pelrun/blutwid/hardware/blutwid.xlsx

 |  |  |  |  |  |  | Board Qty: | 100
 |  |  |  |  |  |  | Total Cost: | $0.00 |  |  |  | $0.00 |  |  |  |  |  | $0.00 |  |  |  |  |  | $0.00
Global Part Info |  |  |  |  |  |  |  |  | Newark |  |  |  |  |  | Digi-Key |  |  |  |  |  | Mouser
Refs | Value | Desc | Footprint | Manf | Manf# | Qty | Unit$ | Ext$ | Avail | Purch | Unit$ | Ext$ | Cat# | Doc | Avail | Purch | Unit$ | Ext$ | Cat# | Doc | Avail | Purch | Unit$ | Ext$ | Cat# | Doc
C9,C10 | 0.1u |  | w_smd_cap:c_0402 |  |  | 0 | $0.00 | $0.00
J1 | KBD/MS |  | w_pin_strip:pin_strip_6 |  |  | 0 | $0.00 | $0.00
C1-C4 | 10uF |  | w_smd_cap:c_1206 |  |  | 0 | $0.00 | $0.00
J2 | SWD |  | w_pin_strip:pin_strip_5 |  |  | 0 | $0.00 | $0.00
J5-J8 | M |  | w_pin_strip:pin_strip_1 |  |  | 0 | $0.00 | $0.00
P2 | BATT |  | w_pin_strip:pin_strip_2 |  |  | 0 | $0.00 | $0.00
C5 | 1uF |  | w_smd_cap:c_0805 |  |  | 0 | $0.00 | $0.00
J3 | BRD1 |  | w_pin_strip:pin_strip_6 |  |  | 0 | $0.00 | $0.00
U5 | STM32F030 |  | w_smd_lqfp:lqfp32 |  | STM32F030K6T6 | 0 | $0.00 | $0.00 | 2 |  | $0.00 | $0.00 | 75X0275 | Link (http://www.newark.com/webapp/wcs/stores/servlet/Search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) | 5690 |  | $0.00 | $0.00 | 497-14046-ND | Link (http://www.digikey.com/scripts/DkSearch/dksus.dll?WT.z_header=search_go&lang=en) | 3442 |  | $0.00 | $0.00 | 511-STM32F030K6T6 | Link (http://www.mouser.com/Search/Refine.aspx?Keyword=STM32F030K6T6)
SW1 | WKUP |  | Buttons_Switches_SMD:SW_SPST_EVQP7A |  | EVQP7A01K | 0 | $0.00 | $0.00 | 3065 |  | $0.00 | $0.00 | 83T2830 | Link (http://www.newark.com/panasonic-electronic-components/evq-p7a01p/switch-tactile-spst-no-50ma-12vdc/dp/83T2830) | 0 |  | $0.00 | $0.00 | P12277STR-ND | Link (http://www.digikey.com/scripts/DkSearch/dksus.dll?WT.z_header=search_go&lang=en&keywords=EVQP7A01K) |  |  | $0.00 | $0.00 | 667-EVQ-P7A01K | Link (http://www.mouser.com/Search/Refine.aspx?Keyword=EVQP7A01K)
U2 | Roving_RN-42 |  | w_rf_modules:w_rf_modules%3aroving_rn-42 |  | RN42-I/RM | 0 | $0.00 | $0.00 | 0 |  | $0.00 | $0.00 | 06W3305 | Link (http://www.newark.com/webapp/wcs/stores/servlet/Search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) | 4053 |  | $0.00 | $0.00 | 740-1038-2-ND | Link (http://www.digikey.com/product-detail/en/RN42-I%2FRM/740-1038-2-ND/2742152) | 1662 |  | $0.00 | $0.00 | 765-RN-42 | Link (http://www.mouser.com/Search/../ProductDetail/Microchip-Technology/RN42-I-RM/)
U3 | MCP73831T-2 |  | w_smd_trans:sot23-5 |  | MCP73831T-2ATI/OT | 0 | $0.00 | $0.00 | 997 |  | $0.00 | $0.00 | 84R5196 | Link (http://www.newark.com/microchip/mcp73831t-2ati-ot/battery-charger-500-ma-5-sot-23/dp/84R5196) | 4887 |  | $0.00 | $0.00 | MCP73831T-2ATI/OTCT-ND | Link (http://www.digikey.com/product-detail/en/MCP73831T-2ATI%2FOT/MCP73831T-2ATI%2FOTCT-ND/1979803) | 8496 |  | $0.00 | $0.00 | 579-MCP73831T-2ATIOT | Link (http://www.mouser.com/Search/Refine.aspx?Keyword=MCP73831T-2ATI%2FOT)
P1 | USB-5PIN |  | w_conn_pc:conn_usb_B_micro_smd-2 |  | USB3065-30-00-A | 0 | $0.00 | $0.00 | 1799 |  | $0.00 | $0.00 | 58T0860 | Link (http://www.newark.com/global-connector-technology/usb3065-30-00-a/micro-usb-2-0-type-b-recetpacle/dp/58T0860)
U4 | REG_3V3 |  | w_smd_trans:sot23-5 |  |  | 0 | $0.00 | $0.00
J9 | PWR |  | w_pin_strip:pin_strip_2 |  |  | 0 | $0.00 | $0.00
Q1 | MOS_N_DGS |  | w_smd_trans:sot23 |  |  | 0 | $0.00 | $0.00
J4 | BRD2 |  | w_pin_strip:pin_strip_6 |  |  | 0 | $0.00 | $0.00
U1 | MCP1253-33X50 |  | w_smd_dil:msoic-8 |  | MCP1253-33X50I/MS | 0 | $0.00 | $0.00 | 399 |  | $0.00 | $0.00 | 03H5060 | Link (http://www.newark.com/webapp/wcs/stores/servlet/Search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) | 1013 |  | $0.00 | $0.00 | MCP1253-33X50I/MS-ND | Link (http://www.digikey.com/scripts/DkSearch/dksus.dll?WT.z_header=search_go&lang=en) | 6118 |  | $0.00 | $0.00 | 579-MCP125333X50I/MS | Link (http://www.mouser.com/Search/../ProductDetail/Microchip-Technology/MCP1253-33X50I-MS/)
R3-R6,R9-R11 | 10k |  | w_smd_resistors:r_0402 |  |  | 0 | $0.00 | $0.00
C6,C7 | 1uF/X7R |  | w_smd_cap:c_0402 |  |  | 0 | $0.00 | $0.00
 |  |  |  |  |  |  |  |  |  | 0 | 0 | 0 |  |  |  | 0 | 0 | 0 |  |  |  | 0 | 0 | 0
 |  |  |  |  |  |  |  |  |  | 0 | 0 | 0 |  |  |  | 0 | 0 | 0 |  |  |  | 0 | 0 | 0
 |  |  |  |  |  |  |  |  |  | 0 | 0 | 0 |  |  |  | 0 | 0 | 0 |  |  |  | 0 | 0 | 0
 |  |  |  |  |  |  |  |  |  | 0 | 0 | 0 |  |  |  | 0 | 0 | 0 |  |  |  | 0 | 0 | 0
 |  |  |  |  |  |  |  |  |  | 0 | 0 | 0 |  |  |  | 0 | 0 | 0 |  |  |  | 0 | 0 | 0
 |  |  |  |  |  |  |  |  |  | 0 | 0 | 0 |  |  |  | 0 | 0 | 0 |  |  |  | 0 | 0 | 0
 |  |  |  |  |  |  |  |  |  | 0 | 0 | 0 |  |  |  | 0 | 0 | 0 |  |  |  | 0 | 0 | 0
 |  |  |  |  |  |  |  |  |  | 0 | 0 | 0 |  |  |  | 0 | 0 | 0 |  |  |  | 0 | 0 | 0
 |  |  |  |  |  |  |  |  |  | 0 | 0 | 0 |  |  |  | 0 | 0 | 0 |  |  |  | 0 | 0 | 0
 |  |  |  |  |  |  |  |  |  | 0 | 0 | 0 |  |  |  | 0 | 0 | 0 |  |  |  | 0 | 0 | 0
 |  |  |  |  |  |  |  |  |  | 0 | 0 | 0 |  |  |  | 0 | 0 | 0 |  |  |  | 0 | 0 | 0
 |  |  |  |  |  |  |  |  |  | 0 | 0 | 0 |  |  |  | 0 | 0 | 0 |  |  |  | 0 | 0 | 0
 |  |  |  |  |  |  |  |  |  | 0 | 0 | 0 |  |  |  | 0 | 0 | 0 |  |  |  | 0 | 0 | 0
 |  |  |  |  |  |  |  |  |  | 0 | 0 | 0 |  |  |  | 0 | 0 | 0 |  |  |  | 0 | 0 | 0
 |  |  |  |  |  |  |  |  |  | 0 | 0 | 0 |  |  |  | 0 | 0 | 0 |  |  |  | 0 | 0 | 0
 |  |  |  |  |  |  |  |  |  | 0 | 0 | 0 |  |  |  | 0 | 0 | 0 |  |  |  | 0 | 0 | 0
 |  |  |  |  |  |  |  |  |  | 0 | 0 | 0 |  |  |  | 0 | 0 | 0 |  |  |  | 0 | 0 | 0
 |  |  |  |  |  |  |  |  |  | 0 | 0 | 0 |  |  |  | 0 | 0 | 0 |  |  |  | 0 | 0 | 0
 |  |  |  |  |  |  |  |  |  | 0 | 0 | 0 |  |  |  | 0 | 0 | 0 |  |  |  | 0 | 0 | 0
 |  |  |  |  |  |  |  |  |  | 0 | 0 | 0 |  |  |  | 0 | 0 | 0 |  |  |  | 0 | 0 | 0
