pelrun/blutwid/hardware/blutwid.stl

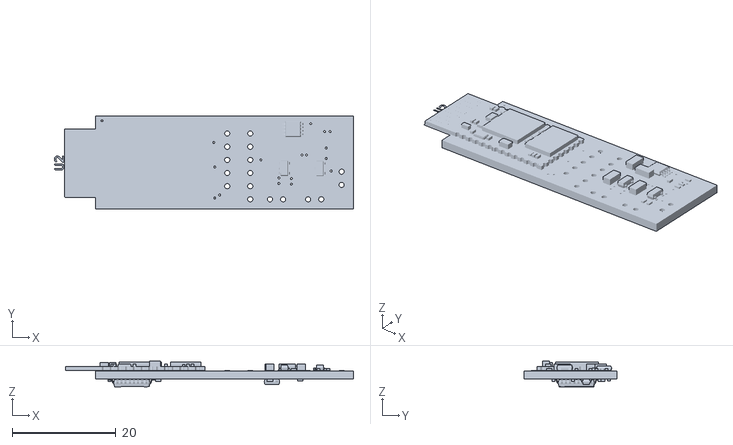
[picture p1: CAD file, 2016-05-05]
hardware/blutwid.stl
57.8 x 18.0 x 4.96
