pelrun/blutwid/(list of files, drawings)

Other design files:
hardware/blutwid.dsn
