pelrun/blutwid/hardware/blutwid.kicad_pcb

## KiCad design hardware/blutwid.kicad_pcb (2016-05-05)

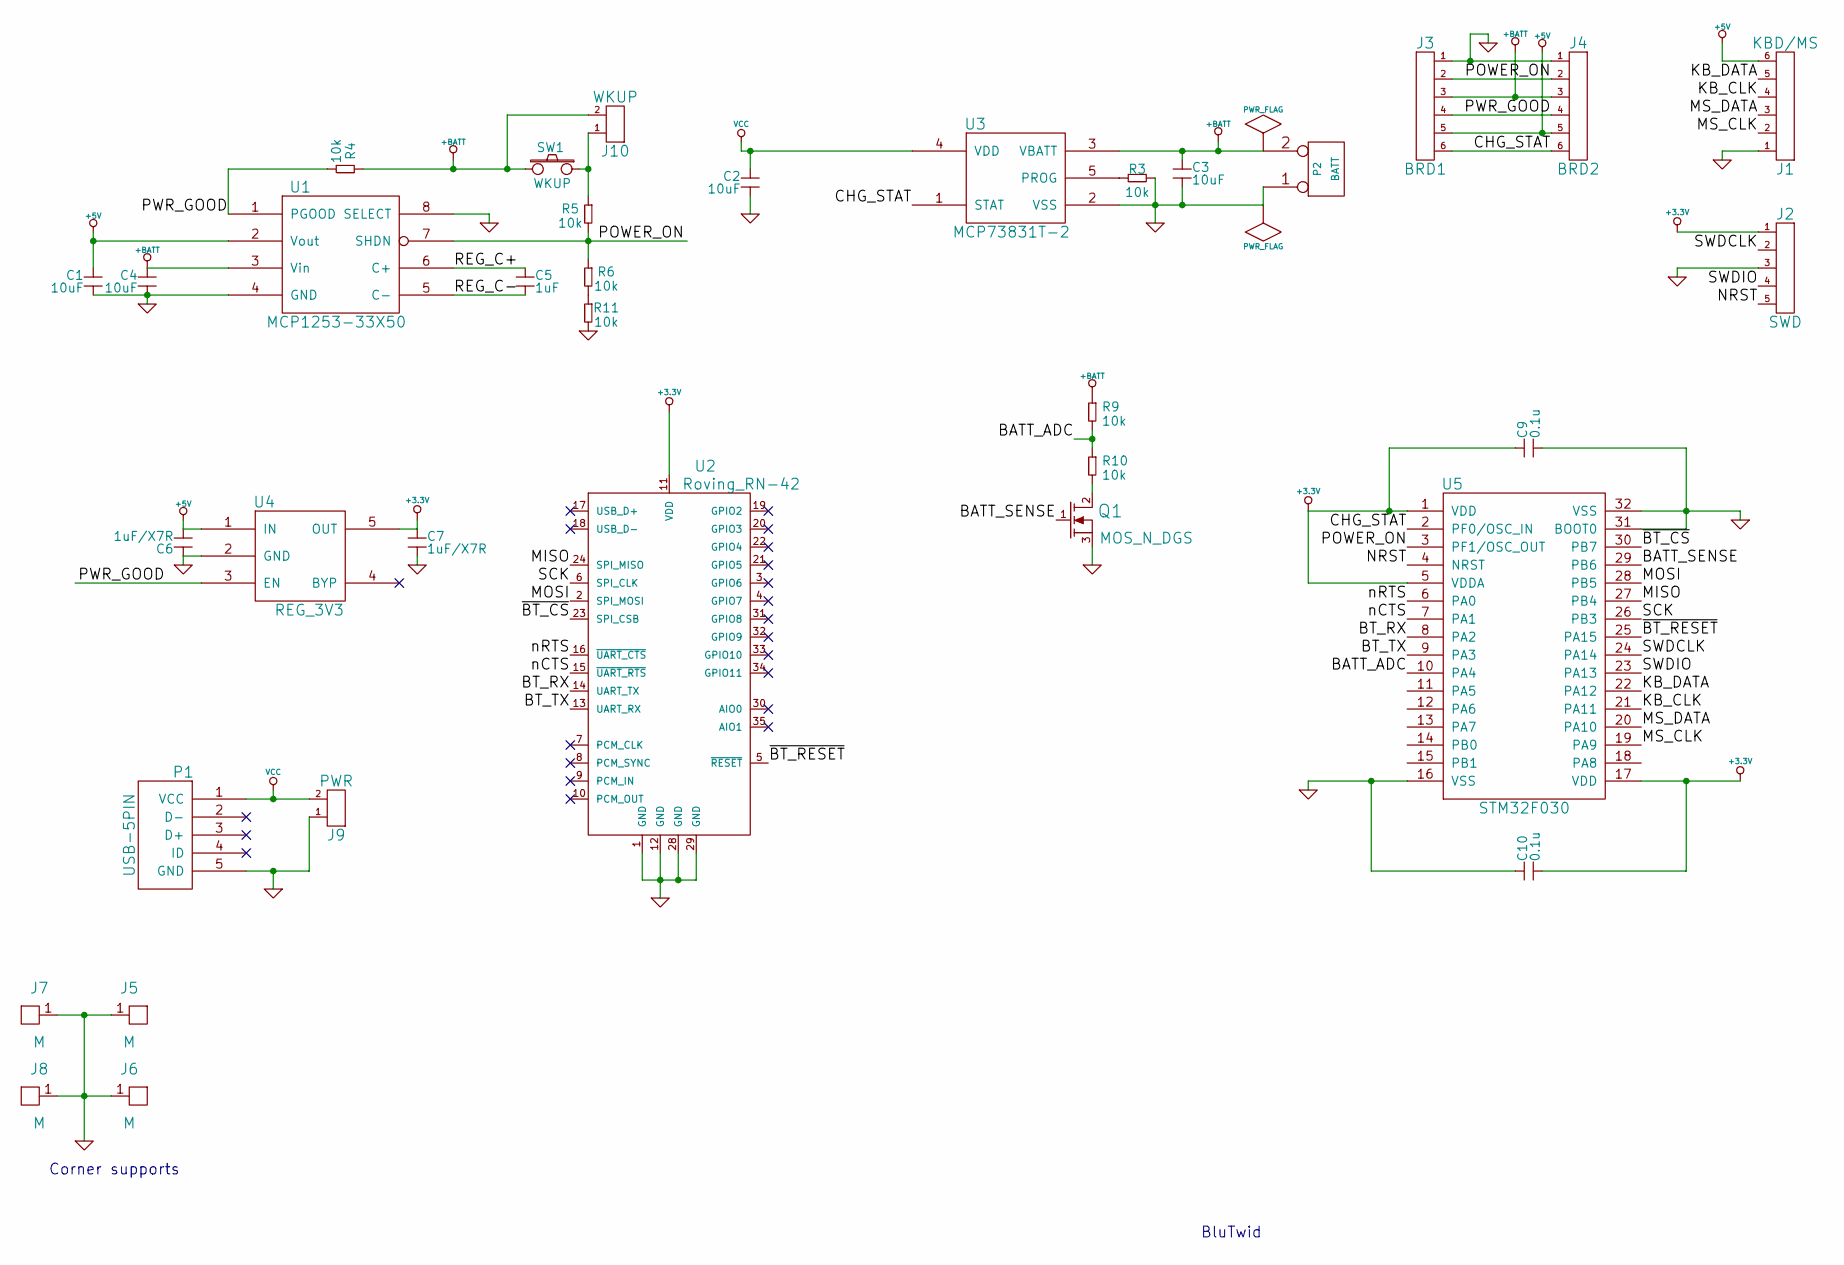
[picture p2: schematic blutwid.sch]

Parts:
C1, C2, C3, C4: 10uF; c_1206
C5: 1uF; c_0805
C6, C7: 1uF/X7R; c_0402
C9, C10: 0.1u; c_0402
J1: KBD/MS; pin_strip_6
J2: SWD; pin_strip_5
J3: BRD1; pin_strip_6
J4: BRD2; pin_strip_6
J5, J6, J7, J8: M; pin_strip_1
J9: PWR; pin_strip_2
J10: WKUP; pin_strip_2
P1: USB-5PIN; conn_usb_B_micro_smd-2
P2: BATT; pin_strip_2
Q1: MOS_N_DGS; sot23
R3, R4, R5, R6, R9, R10, R11: 10k; r_0402
SW1: WKUP; SW_SPST_EVQP7A
U1: MCP1253-33X50; msoic-8
U2: Roving_RN-42; w_rf_modules%3aroving_rn-42
U3: MCP73831T-2; sot23-5
U4: REG_3V3; sot23-5
U5: STM32F030; lqfp32

Connections:
+3.3V: C7.1, C9.1, C10.2, J2.1, U2.11 (VDD), U4.5 (OUT), U5.1 (VDD), U5.5 (VDDA), U5.17 (VDD)
+5V: C1.1, C6.2, J1.6, J3.5, J4.5, U1.2 (Vout), U4.1 (IN)
+BATT: C3.1, C4.1, J3.3, J4.3, J10.2, P2.2 (PM), R4.1, R9.1, SW1.2, U1.3 (Vin), U3.3 (VBATT)
/BATT_ADC: R9.2, R10.1, U5.10 (PA4)
/BATT_SENSE: Q1.1 (G), U5.29 (PB6)
/BT_RX: U2.14 (UART_TX), U5.8 (PA2)
/BT_TX: U2.13 (UART_RX), U5.9 (PA3)
/CHG_STAT: J3.6, J4.6, U3.1 (STAT), U5.2 (PF0/OSC_IN)
/KB_CLK: J1.4, U5.21 (PA11)
/KB_DATA: J1.5, U5.22 (PA12)
/MISO: U2.24 (SPI_MISO), U5.27 (PB4)
/MOSI: U2.2 (SPI_MOSI), U5.28 (PB5)
/MS_CLK: J1.2, U5.19 (PA9)
/MS_DATA: J1.3, U5.20 (PA10)
/NRST: J2.5, U5.4 (NRST)
/POWER_ON: J3.2, J4.2, R5.2, R6.1, U1.7 (SHDN), U5.3 (PF1/OSC_OUT)
/PWR_GOOD: J3.4, J4.4, R4.2, U1.1 (PGOOD), U4.3 (EN)
/REG_C+: C5.1, U1.6 (C+)
/REG_C-: C5.2, U1.5 (C-)
/SCK: U2.6 (SPI_CLK), U5.26 (PB3)
/SWDCLK: J2.2, U5.24 (PA14)
/SWDIO: J2.4, U5.23 (PA13)
/nCTS: U2.15 (~UART_RTS), U5.7 (PA1)
/nRTS: U2.16 (~UART_CTS), U5.6 (PA0)
/~BT_CS: U2.23 (SPI_CSB), U5.30 (PB7)
/~BT_RESET: U2.5 (~RESET), U5.25 (PA15)
GND: C1.2, C2.2, C3.2, C4.2, C6.1, C7.2, C9.2, C10.1, J1.1, J2.3, J3.1, J4.1, J5.1, J6.1, J7.1, J8.1, J9.1, P1.5 (GND), P2.1, Q1.3 (S), R3.2, R11.2, U1.4 (GND), U1.8 (SELECT), U2.1 (GND), U2.12 (GND), U2.28 (GND), U2.29 (GND), U3.2 (VSS), U4.2 (GND), U5.16 (VSS), U5.31 (BOOT0), U5.32 (VSS)
unnamed: J10.1, R5.1, SW1.1
unnamed: Q1.2 (D), R10.2
unnamed: R3.1, U3.5 (PROG)
unnamed: R6.2, R11.1
VCC: C2.1, J9.2, P1.1 (VCC), U3.4 (VDD)

Notes on the sheet:
BluTwid
Corner supports

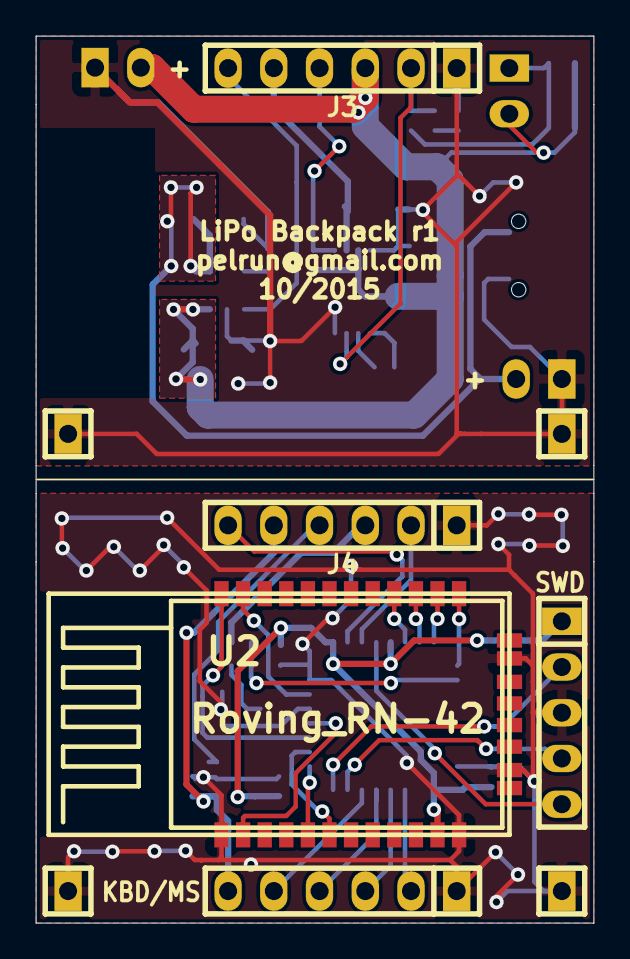
[picture p3: board blutwid.kicad_pcb from above]

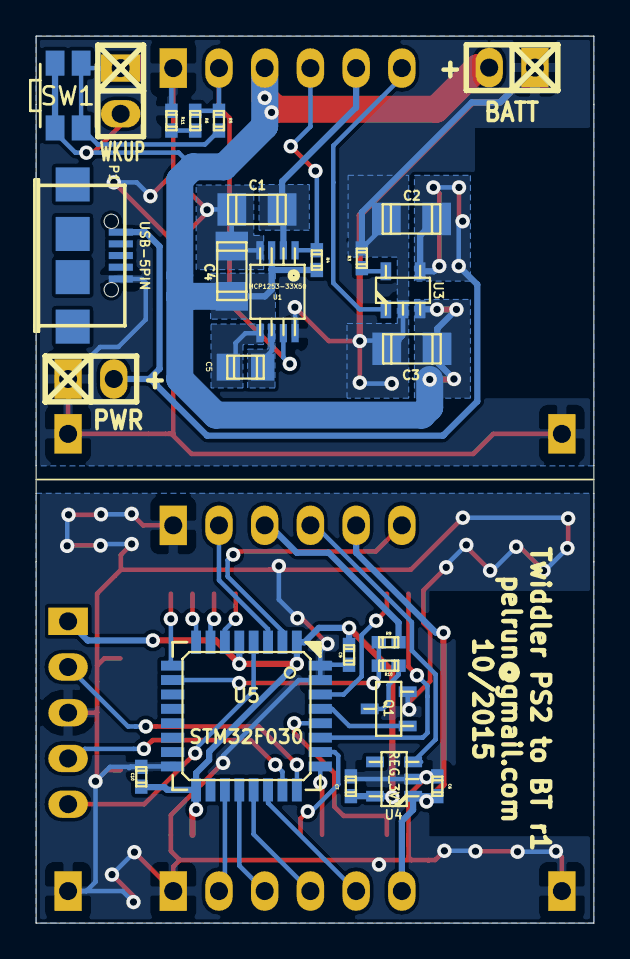
[picture p4: board blutwid.kicad_pcb from below]

Board: 2 copper layers, 31.0 x 49.3 mm, 36 parts (26 on the bottom side), 32 nets.

Other parts of the board:
SLOT: SLOT; MountingHole_2-5mm
