pelrun/blutwid/firmware/BluTwid/BluTwid.ioc

Mcu.UserName=STM32F030K6Tx
PA0.Signal=USART1_CTS
PA1.Signal=USART1_RTS
PA10.GPIO_Label=MS_DATA
PA10.Signal=GPIO_Output
PA11.GPIO_Label=KB_CLK
PA11.Signal=GPIO_Output
PA12.GPIO_Label=KB_DATA
PA12.Signal=GPIO_Output
PA13.Signal=SYS_SWDIO
PA14.Signal=SYS_SWCLK
PA15.GPIO_Label=BT_nRESET
PA15.Signal=GPIO_Output
PA2.GPIO_Label=BT_RX
PA2.Signal=USART1_TX
PA3.GPIO_Label=BT_TX
PA3.Signal=USART1_RX
PA4.GPIO_Label=BATT_ADC
PA4.Signal=ADC_IN4
PA9.GPIO_Label=MS_CLK
PA9.Signal=GPIO_Output
PB3.Signal=SPI1_SCK
PB4.Signal=SPI1_MISO
PB5.Signal=SPI1_MOSI
PB6.GPIO_Label=BATT_SENSE
PB6.Signal=GPIO_Output
PB7.GPIO_Label=BT_nCS
PB7.Signal=GPIO_Output
PF0-OSC_IN.GPIO_Label=CHG_STAT
PF0-OSC_IN.Signal=GPIO_Input
PF1-OSC_OUT.GPIO_Label=POWER_ON
PF1-OSC_OUT.Signal=GPIO_Output
