pelrun/blutwid/firmware/BluTwid/Inc/blutwid.h

/*
 * blutwid.h
 *
 *  Created on: May 12, 2016
 *      Author: James
 */

#ifndef INC_BLUTWID_H_
#define INC_BLUTWID_H_

#define BT_IDLE_POWEROFF_TIMEOUT_MS (5*60*1000)

#define BT_BATTERY_CHECK_INTERVAL_MS (30*1000)
#define BT_BATTERY_LEVEL_CRITICAL_mV 3200

#define BT_PS2_READ_TIMEOUT_MS 100
#define BT_PS2_WRITE_TIMEOUT_MS 100

#define MAX_KEYS_PRESSED 6

#endif /* INC_BLUTWID_H_ */
